hess4steve/FaradayCageDev/Faraday_Cage_Shopping_List.xlsx

Item | Amount needed | Price | Link | Total cost | Notes (READ BEFORE PURCHASE!)
(4 Per Pack) M6 nut and bolt for 30mm high rail | 41 | $3.25 | https://www.mcmaster.com/3136N402/ | $133.25 | I actually used https://www.mcmaster.com/5537t868/ HOWEVER I do not reccomend that you do. They were a poor choice because of the fact they need to be inserted from the ends and it is very easy to be confused and need to dismantle one part to put them inside. Also, the screw length was a tiny bit too long, so they mandated a hole to be drilled into the aluminum EVERY TIME. I do not reccomend. That is why I have recommended this different option to you! Anything using M6 meant for 30mm rails with a thread length less than 16mm should be okay. I HAVE NOT TESTED the replacement shown in the "link" column, but it looks like it would work as a replacement. If you opt to buy what I did, at least shorten the screws and save yourself and your drill bits from drilling holes in aluminum every single screw so that it tightens all the way. If you can buy cheaper elsewhere in bulk, do it! I could not as I was limited in my supplier choices.
Door Handles | 2 | $37.90 | https://www.mcmaster.com/2471N4/ | $75.80 | These didn't work too nicely and were a bit too big for my liking. I had to modify the holes in there to allow it to work with the design. Were I to do this again, I would have likely chosen a different option, such as 3d printing a design, or going to the hardware store and finding something suitable.
Door Hinges | 4 | $15.83 | https://www.mcmaster.com/5537T847/ | $63.32 | These worked great. No complaints.
Copper Mesh, 1.22 m x 1.22 m | 3 | $156.35 | https://www.thorlabs.com/thorproduct.cfm?partnumber=PSY406 | $469.05 | Cutting this precisely was not really a good idea. It made assembly much harder. Just get a third one.
Access Port for wires to go into cage | 1 | $28.60 | https://www.thorlabs.com/thorproduct.cfm?partnumber=PSY405 | $28.60 | Installation was pretty simple. You might need to have help with a second person though.
30mm High Aluminum rails, 3 feet increments | 22 | $17.58 | https://www.mcmaster.com/5537T97-5537T738/ | $386.76 | You may need more or less depending on the size you choose. All my parts were between 2 and 3 feet long, so I ordered them 3 feet long.
Rubber Seal (Keeps mesh in rails) | 100ft | $1.81 | https://www.mcmaster.com/1142a49/ | $181.00 | While you don't need 100 feet, you pay a higher rate for 1-99 feet orders. Break even point is 84.58 feet. You need around 90 feet, a little less, but it's less expensive to get 100 feet than it is to get any amount between 84.58 feet and 100 feet. So it saves you money. And you get extras. Woo!
GRAND TOTAL |  |  |  | $1337.78 | The project required sourcing exclusively from two suppliers, prioritizing reliability, fast shipping, and exact part availability over price. That said I would just go to a hardware store for most of this if you can find it there, except for the copper mesh. Aluminum would be cheaper for a mesh but less effective.
