hess4steve/FaradayCageDev/3D_Printed_Bracket_Files/LBW_Bracket_Front_Cage.stl

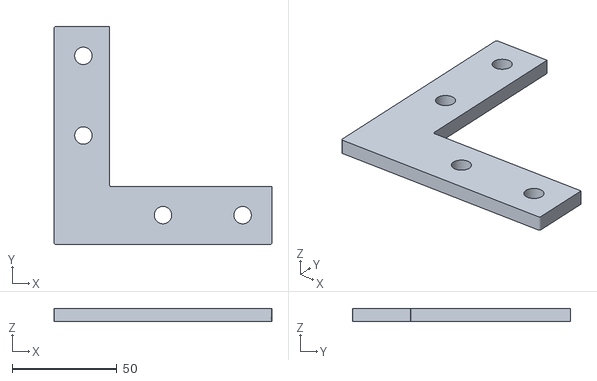
[picture p2: CAD file, 2025-07-08]
3D_Printed_Bracket_Files/LBW_Bracket_Front_Cage.stl
104.3 x 104.3 x 6.35
