hess4steve/FaradayCageDev/3D_Printed_Bracket_Files/Double_Bracket_Middle_Support.stl

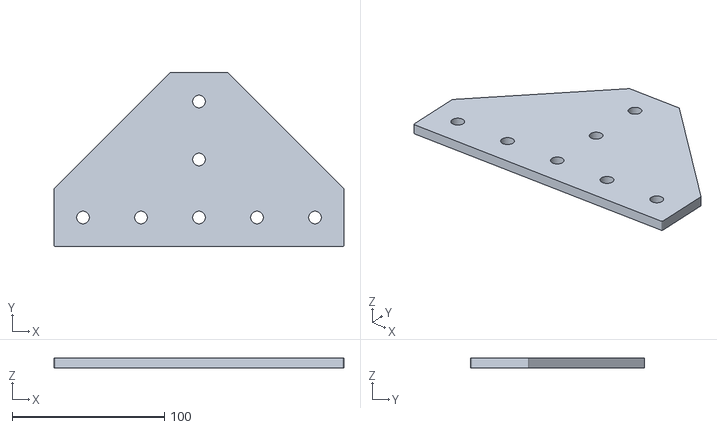
[picture p3: CAD file, 2025-07-08]
3D_Printed_Bracket_Files/Double_Bracket_Middle_Support.stl
190.5 x 114.3 x 6.35
