hess4steve/FaradayCageDev/3D_Printed_Bracket_Files/Triangle_Corner_Bracket.stl

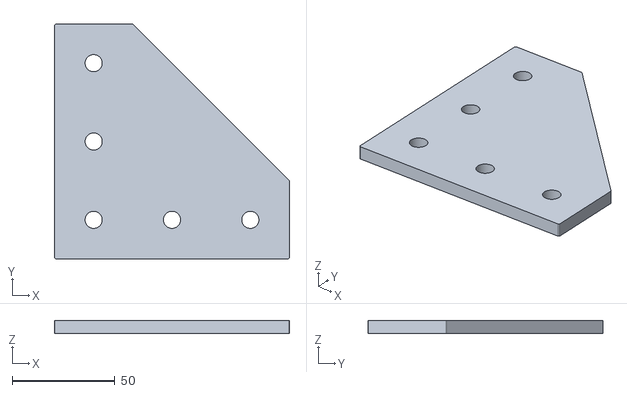
[picture p4: CAD file, 2025-07-08]
3D_Printed_Bracket_Files/Triangle_Corner_Bracket.stl
114.3 x 114.3 x 6.35
