hess4steve/FaradayCageDev/(list of files, cad)

Other CAD files:
CAD_Files/FaradayCageCadModel.stl
