hess4steve/FaradayCageDev/TestingResults/Averaged.png

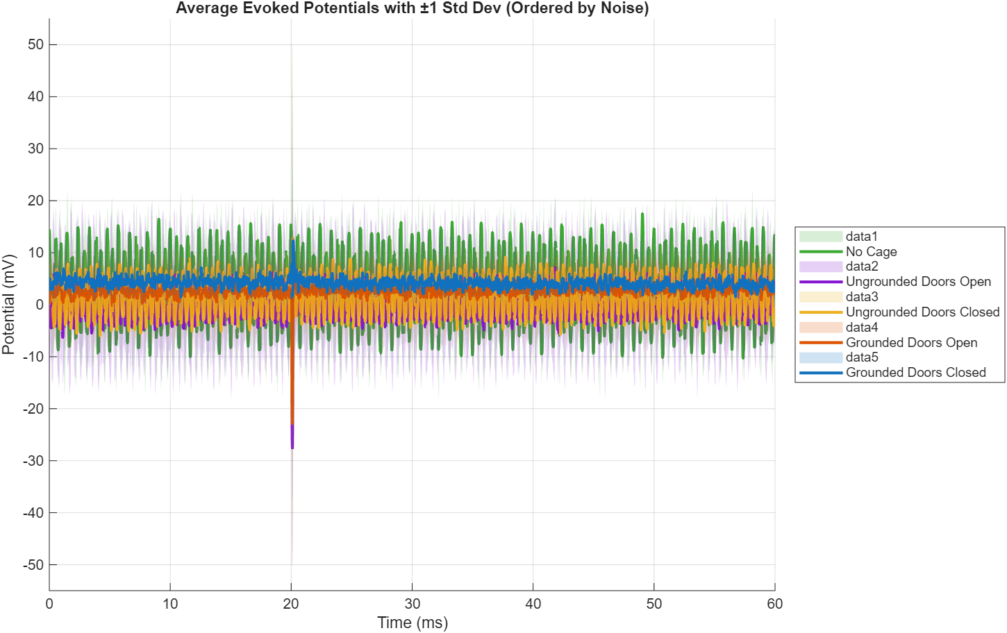
TestingResults/Averaged.png
