hess4steve/FaradayCageDev/TestingResults/MQP_Noise_All_Trials_Together.png

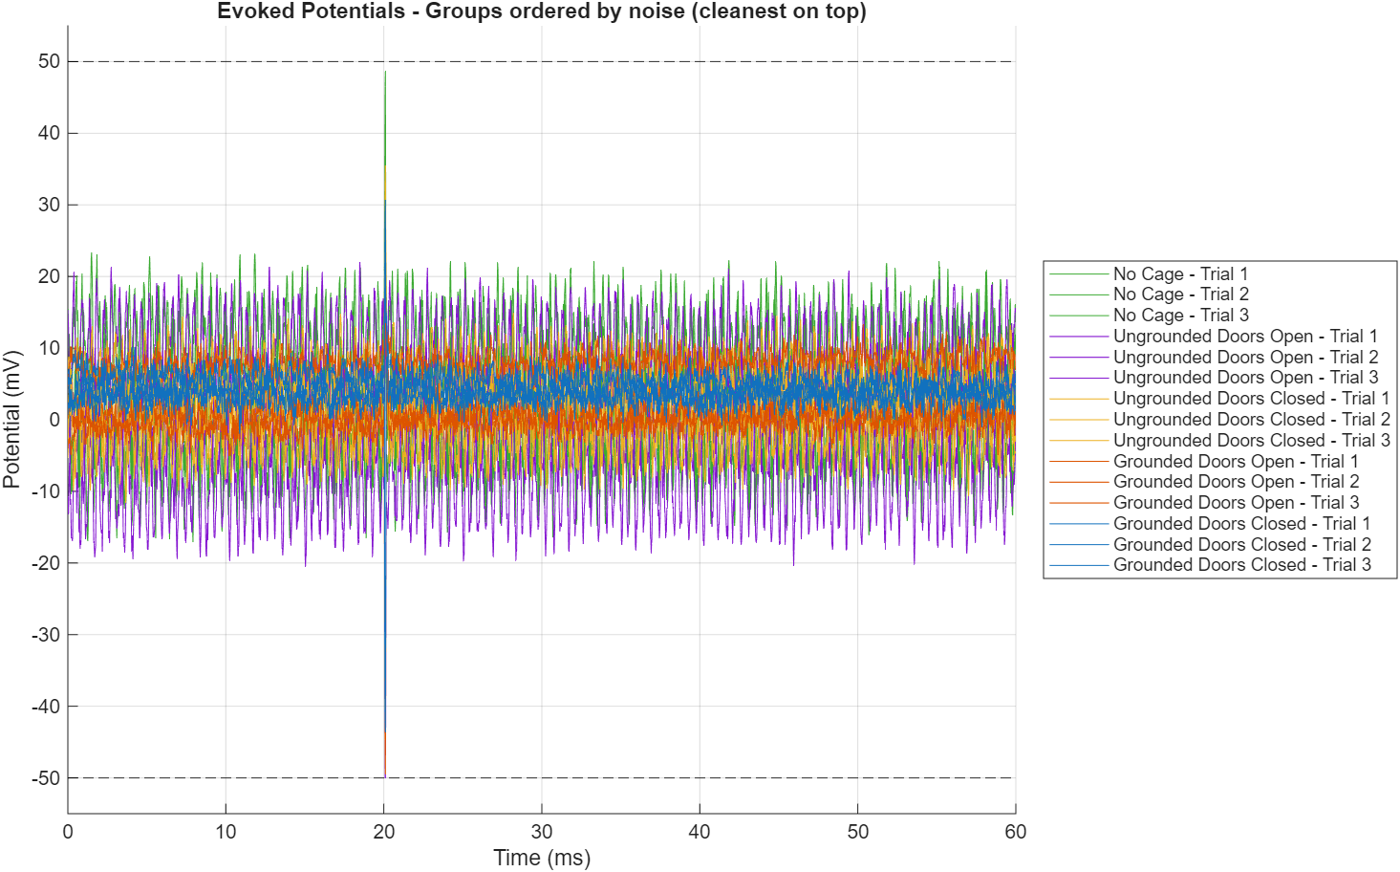
TestingResults/MQP_Noise_All_Trials_Together.png
