hess4steve/FaradayCageDev/TestingResults/NoiseReduction.png

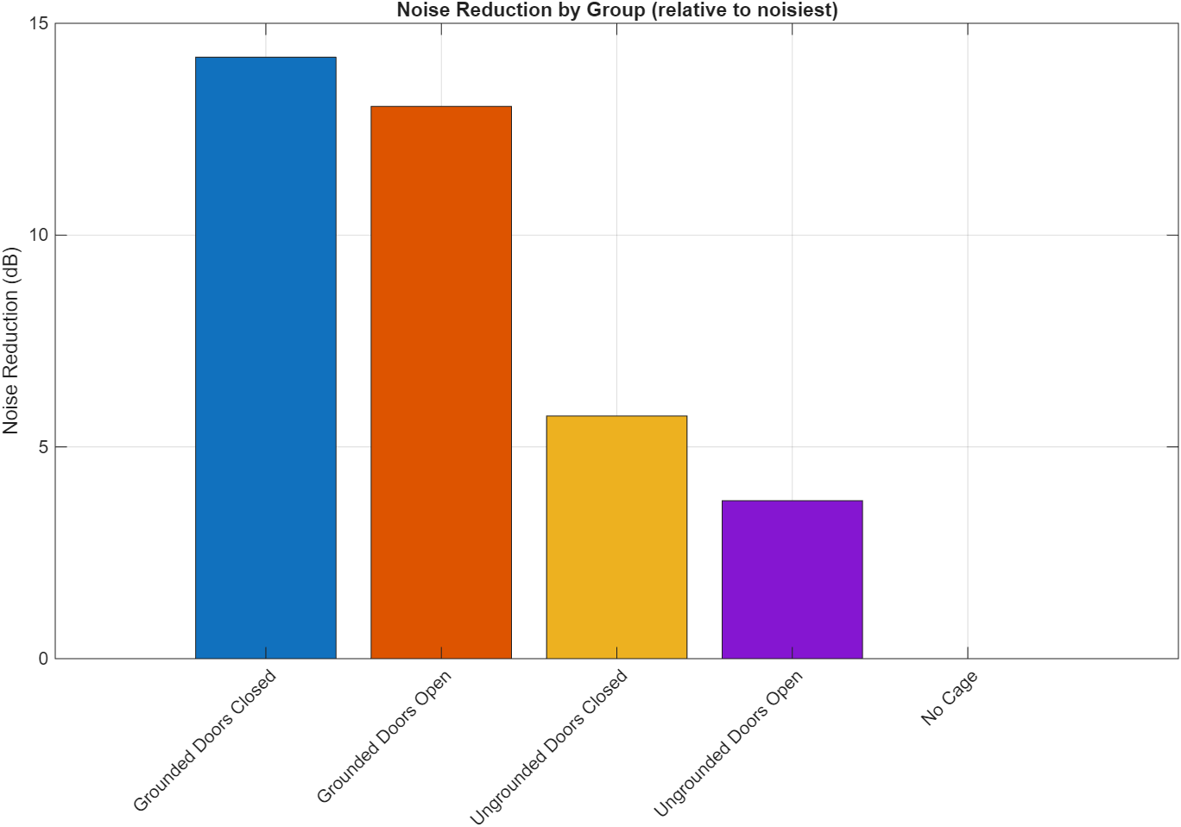
TestingResults/NoiseReduction.png
