hess4steve/FaradayCageDev/TestingResults/Trial1.png

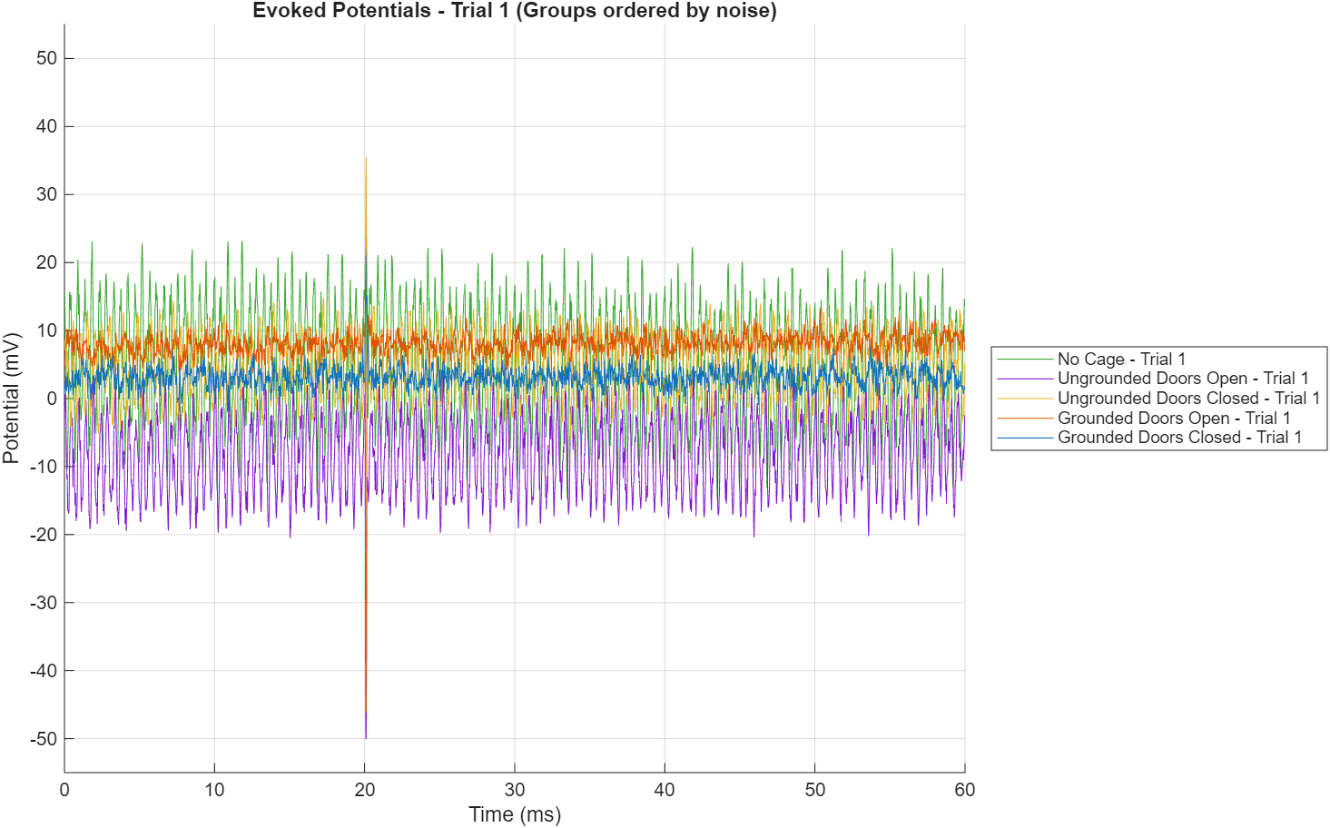
TestingResults/Trial1.png
