hess4steve/FaradayCageDev/TestingResults/Trial2.png

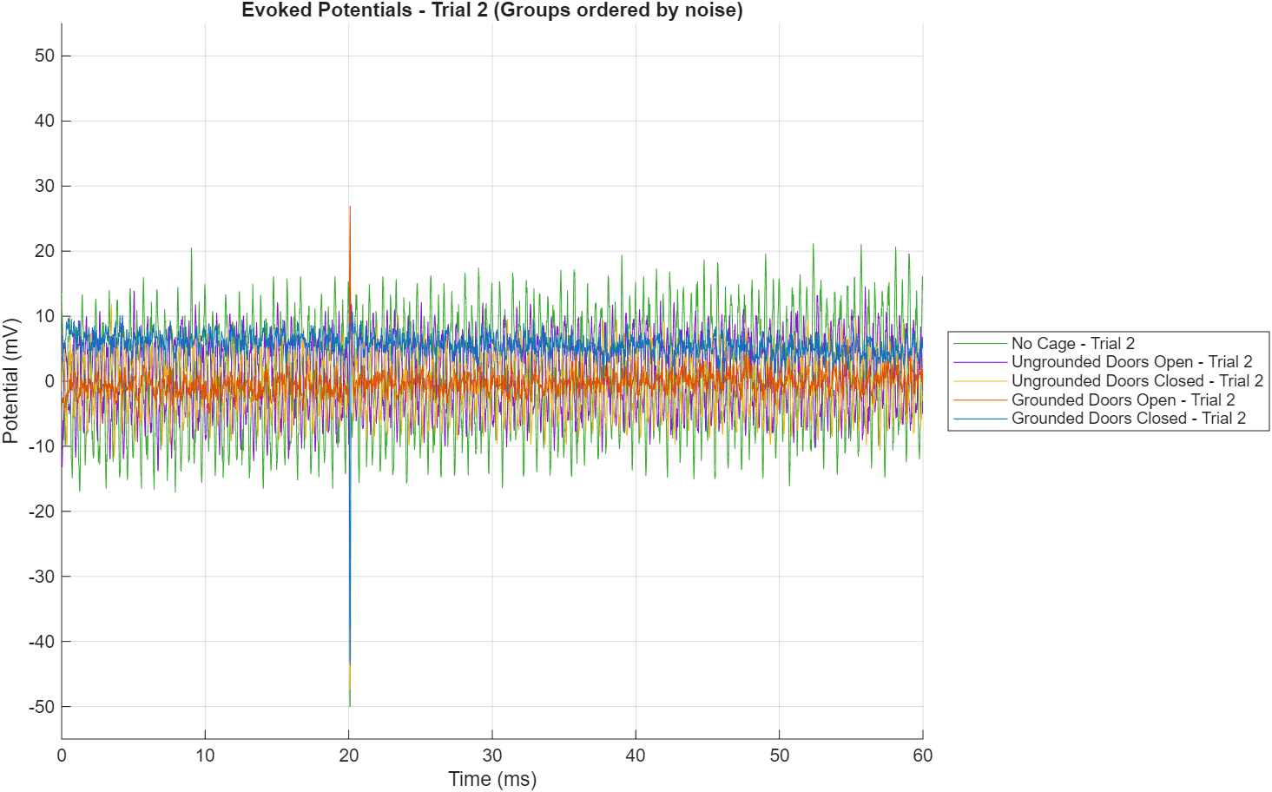
TestingResults/Trial2.png
