hess4steve/FaradayCageDev/TestingResults/Trial3.png

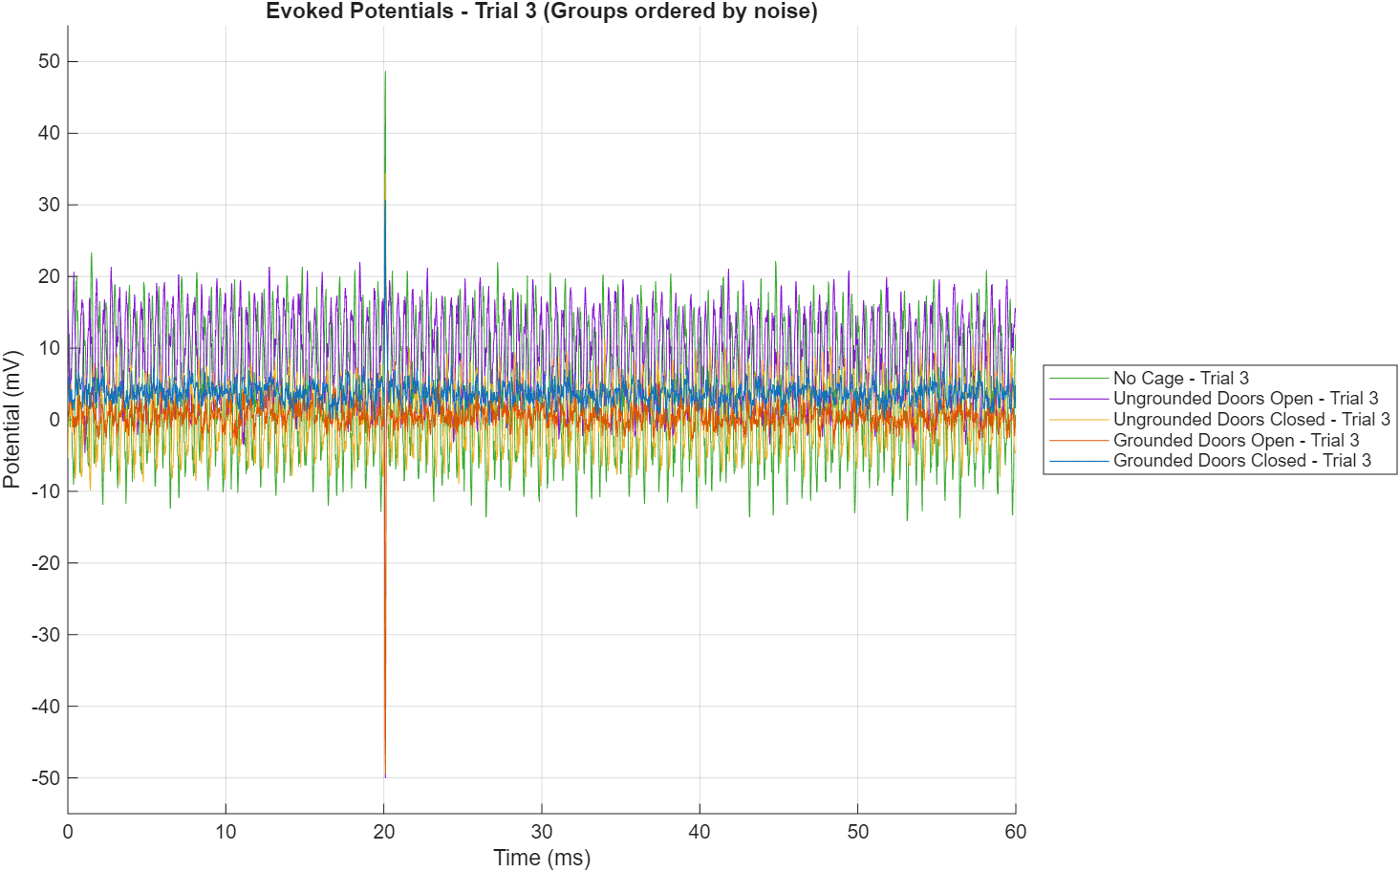
TestingResults/Trial3.png
