hess4steve/FaradayCageDev/(commit log)

2025-07-08 Original CAD File
    Yes I know Blender is not a typical CAD software but it's what I use. I will upload more formats soon
2025-07-08 Shopping list
    [Faraday_Cage_Shopping_List.xlsx]
2025-07-09 The first revision of the instructions for assembly!
